mike-kelly/midi2cv/midi2cv.sch

## KiCad design midi2cv.sch (2021-04-29)

Schematic: midi2cv.sch

Parts:
C1, C2, C3, C4, C5: 0.1uF; C_Rect_L4.0mm_W2.5mm_P2.50mm
Clock1: Clock; TEST POINT
Control0-4V1: Control 0-4V; TEST POINT
Control-8-0V1: Control -8-0V; TEST POINT
D1: DIODE-D-10; Diode-DO-41CA
D2: LED; LED3mm
DAC1, DAC2: MCP4822
Gate1: Gate; TEST POINT
IC1: LM324N
J1: CONN_03; SolderWire-0.5sqmm_1x03_P4.6mm_D0.9mm_OD2.1mm
J2, J3: M15; PinHeader_1x15_P2.54mm_Vertical
NP_SEL1: CONN_03; PinHeader_1x03_P2.54mm_Vertical
Note1: Note; TEST POINT
OK1: SFH618?A; SFH618A-2
Pitchbend1: Pitch Bend; TEST POINT
R1, R15: 220; MusicThingModular-10MM_RESISTOR
R2, R4, R5: 1K; MusicThingModular-10MM_RESISTOR
R3: 500; MusicThingModular-10MM_RESISTOR
R6, R9, R11, R13, R14: 10K; MusicThingModular-10MM_RESISTOR
R7: 3K; MusicThingModular-10MM_RESISTOR
R8: 4.7K; MusicThingModular-10MM_RESISTOR
R10: 30K; MusicThingModular-10MM_RESISTOR
R12: 20K; MusicThingModular-10MM_RESISTOR
RV1: 1K; 64WR20KLF
SW1: SW_SPST; TestPoint_2Pads_Pitch5.08mm_Drill1.3mm
Trigger1: Trigger; TEST POINT
U1: TL072; MusicThingModular-DIL08
U$1: MIDIJACK; SD-50BV-5DIN
Velocity1: Velocity; TEST POINT
